BirkanG/EE463-Hardware-Project/README.md

# EE463-Hardware-Project
Wind Turbine Battery Charger AC-DC converter

[Final Report](Final%20Report/EE463%20HardwareProject-FinalReport.pdf)
