BirkanG/EE463-Hardware-Project/mosfet rectifier ltspice/PMOS/link.txt

https://www.digikey.com/en/products/filter/single-fets-mosfets/278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
