BirkanG/EE463-Hardware-Project/buck converter trial/schematic_regulated_v1.png

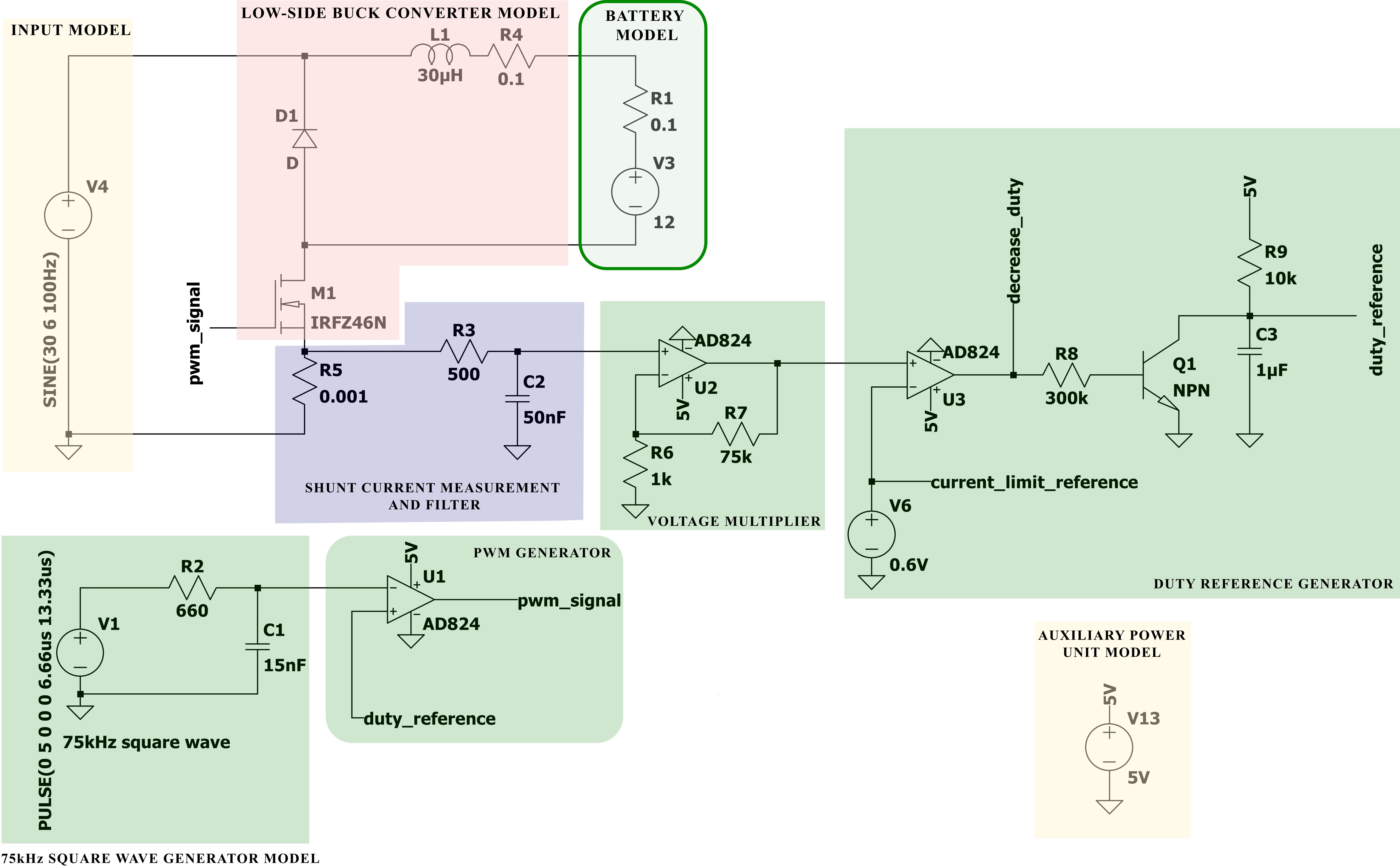
buck converter trial/schematic_regulated_v1.png
