BirkanG/EE463-Hardware-Project/mosfet rectifier ltspice/PMOS/Pmos.PNG

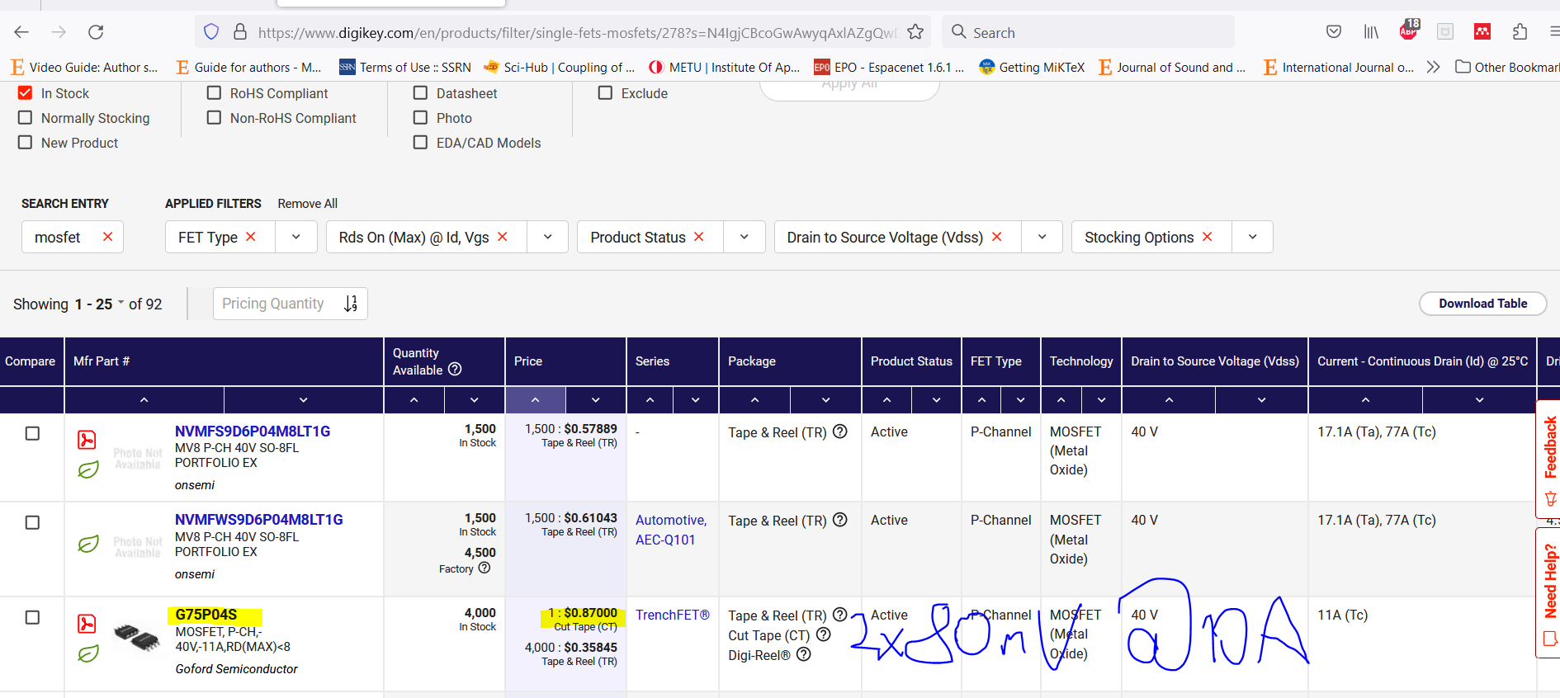
mosfet rectifier ltspice/PMOS/Pmos.PNG
