BirkanG/EE463-Hardware-Project/buck converter trial/results_1.pdf

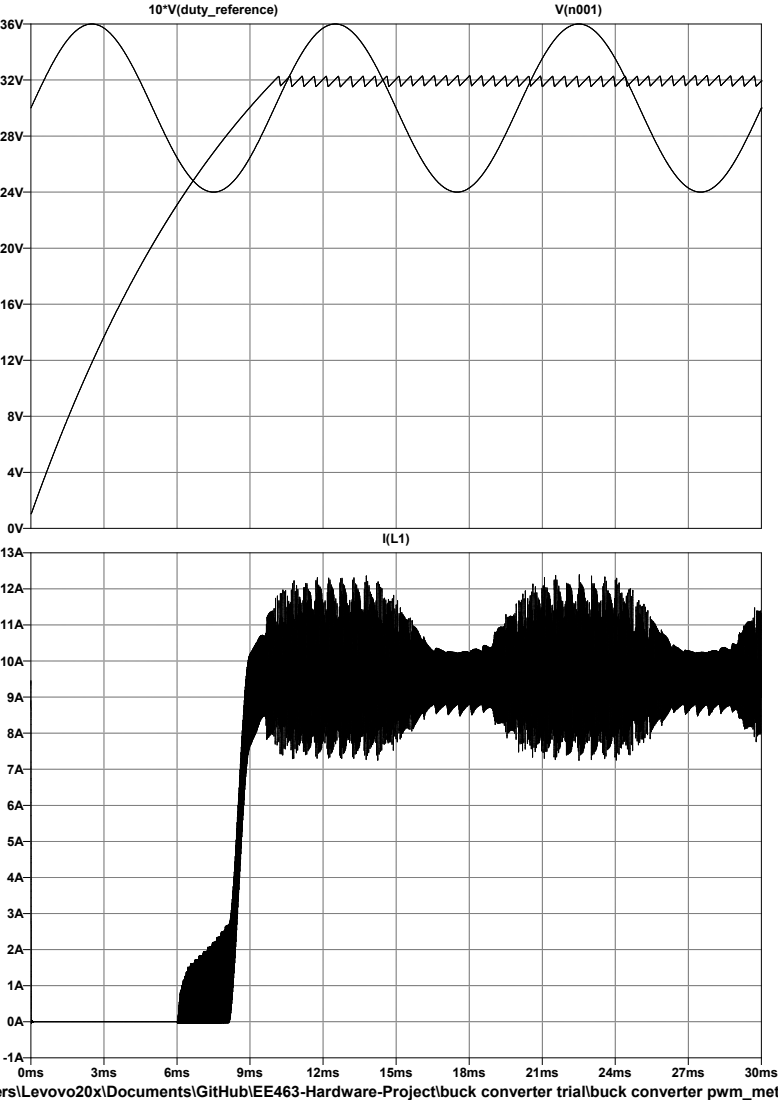
[picture p45: page 1]
10*V(duty_reference)

--- C:\Users\Levovo20x\Documents\GitHub\EE463-Hardware-Project\buck converter trial\buck converter pwm_method.raw ---
