BirkanG/EE463-Hardware-Project/buck converter trial/schematic_regulated_v1.pdf

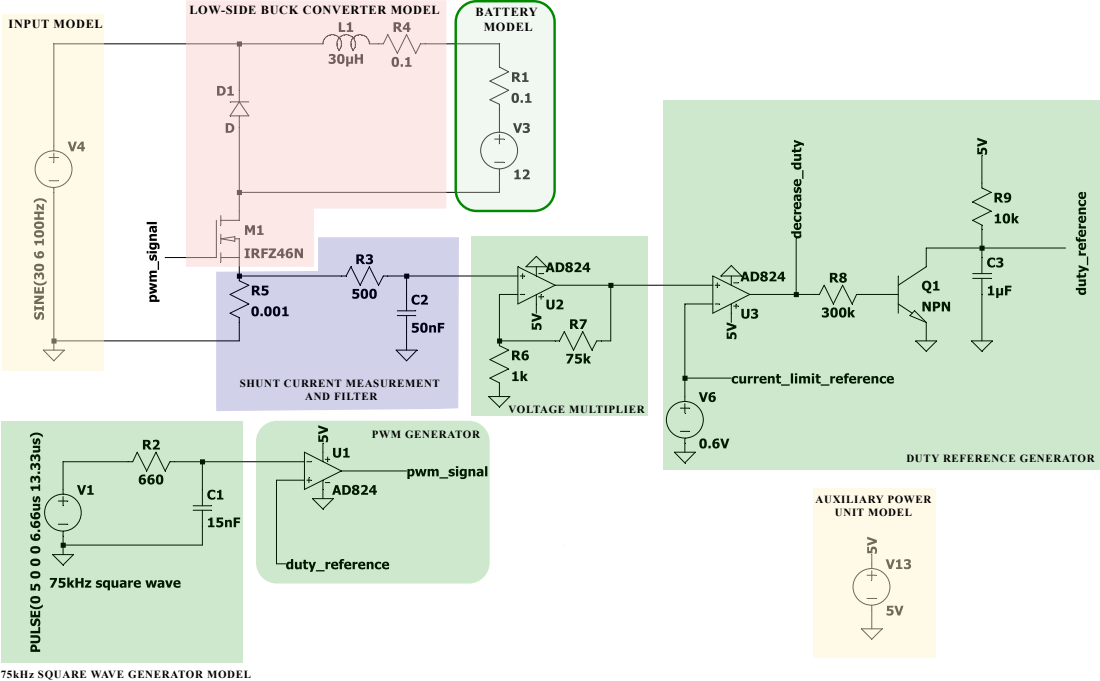
[picture p46: page 1]
INPUT MODEL; BATTERY MODEL; AND FILTER; VOLTAGE MULTIPLIER; AUXILIARY POWER UNIT MODEL; PWM GENERATOR

LOW-SIDE BUCK CONVERTER MODEL

SHUNT CURRENT MEASUREMENT

DUTY REFERENCE GENERATOR

75kHz SQUARE WAVE GENERATOR MODEL
