BirkanG/EE463-Hardware-Project/buck converter trial/second regulated circuit.pdf

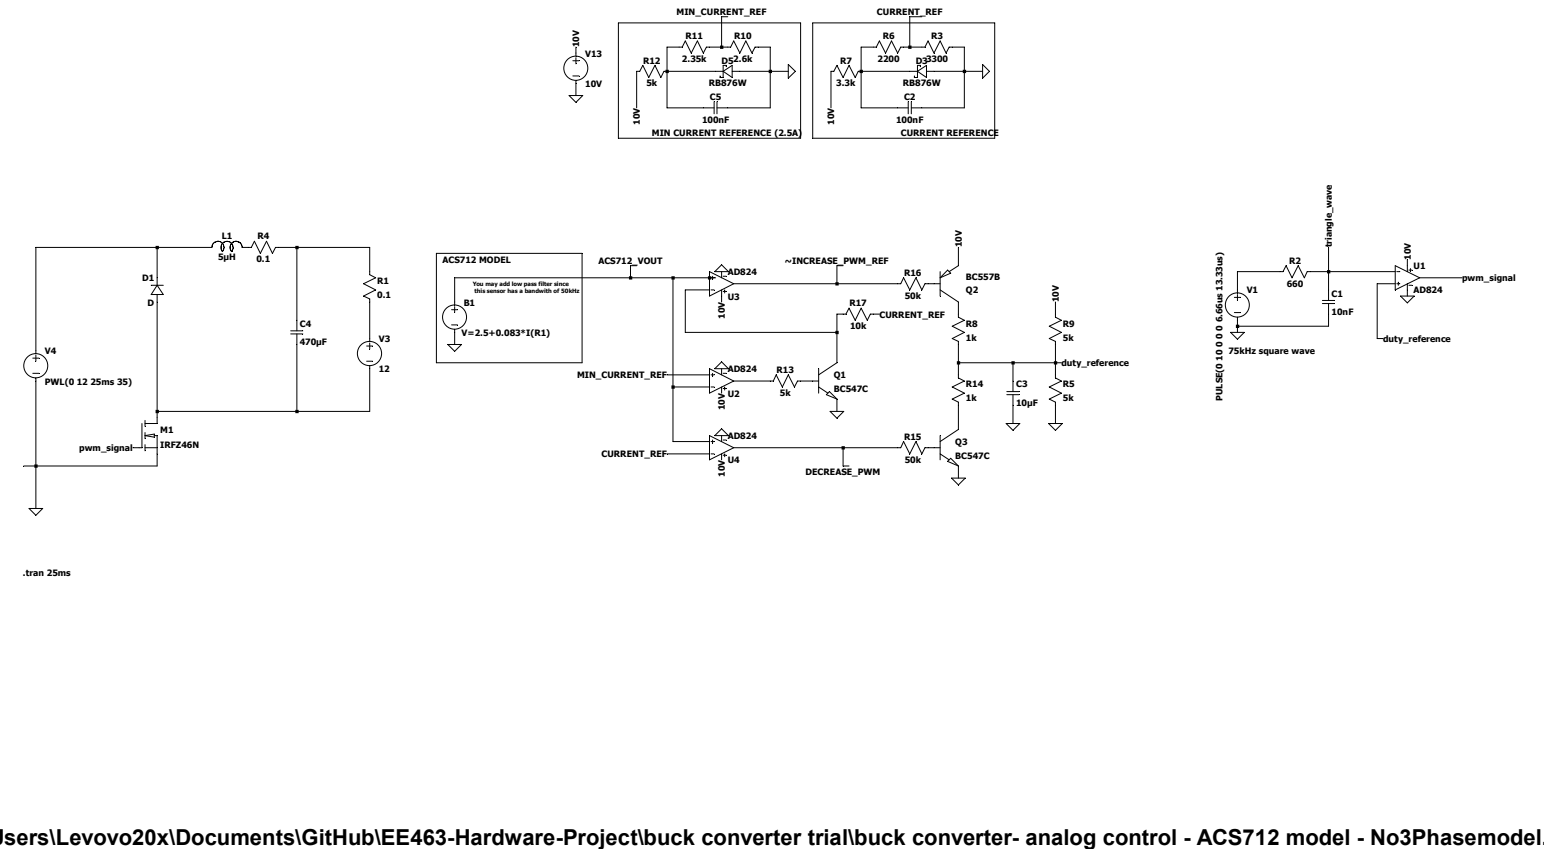
[picture p47: page 1]

You may add low pass filter since
this sensor has a bandwith of 50kHz

--- C:\Users\Levovo20x\Documents\GitHub\EE463-Hardware-Project\buck converter trial\buck converter- analog control - ACS712 model - No3Phasemodel.asc ---
