BirkanG/EE463-Hardware-Project/buck converter trial/first regulated circuit.pdf

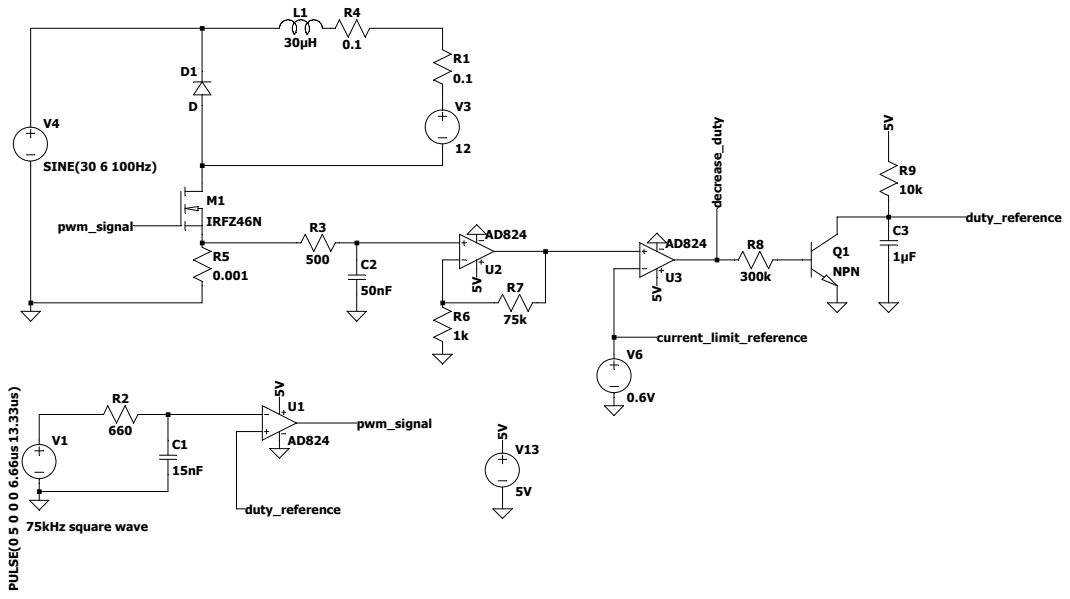
[picture p48: page 1]
