BirkanG/EE463-Hardware-Project/buck converter trial/Draft2.asc

L1: ind
R1: res; 220
U1: SCR; TN6050HP-12
V1: voltage; SINE(0 220V 50)
V2: voltage; PULSE(0 10V 5ms 0 0 1ms 20ms)
Named nets: 0
.tran 20ms
.inc C:\\Program Files\\LTC\\LTspiceXVII\\lib\\st_high-temperature_scr_pspice\\st_high-temperature_scr.lib
