BirkanG/EE463-Hardware-Project/buck converter trial/buck converter- analog control - ACS712 model - No3Phasemodel -Gate driver - PID.asc

B1: bv; V=2.5+0.083*I(R1)
C1: cap; 1nF
C2: cap; 3nF
C3: cap; 100nF
C4: cap; 2200µF
C5: cap; 25nF
C6: cap; 25nF
D1: diode
D2: diode
L1: ind; 10µH
M1: nmos; IRFZ46N
Q1: npn; BC546B
R1: res; 0.05
R2: res; 10k
R3: res; 5k
R4: res; 0.1
R5: res; 10k
R6: res; 5k
R7: res; 5k
R8: res; 1k
R9: res; 1k
R10: res; 4k
R11: res; 1k
R12: res; 200k
R13: res; 10k
R14: res; 10k
R15: res; 25k
R16: res; 10k
R17: res; 10k
R18: res; 10k
R19: res; 10k
R20: res; 10k
R21: res; 10k
R23: res; 1k
R24: res; 5k
R25: res; 10k
R26: res; 10k
U1: AD824
U2: AD824
U3: AD824
U4: AD824
U5: AD824
U6: AD824
U7: AD824
U8: AD824
U9: AD824
V1: voltage; -10V
V2: voltage; 10V
V3: voltage; 12
V4: voltage; SINE(30 8 150)
V5: voltage; 3.33V
V13: voltage; 5V
X1: ir2184
Named nets: 0, 5V, ACS712_VOUT, 10V, TRIANGLE_75kHz, SQUARE_75kHz, PWM_SIGNAL, ERROR_PROPORTIONAL, -10V, ~ERROR_INTEGRAL, ERROR_INTEGRAL, PWM_REFERENCE, ~ERROR_DERIVATIVE, ERROR_DERIVATIVE
ACS712 MODEL
You may add low pass filter since
 this sensor has a bandwith of 50kHz
.tran 0 10ms 0ms
