BirkanG/EE463-Hardware-Project/buck converter trial/buck converter- analog control - ACS712 model - No3Phasemodel -Gate driver.asc

B1: bv; V=2.5+0.083*I(R1)
C1: cap; 1nF
C2: cap; 5nF
C4: cap; 47µF
D1: diode
L1: ind; 15µH
M1: nmos; IRFZ46N
Q1: npn
Q2: pnp
R1: res; 0.05
R2: res; 1
R3: res; 5k
R4: res; 0.1
R5: res; 8k
R6: res; 5k
R7: res; 5k
R8: res; 1k
R9: res; 1k
R10: res; 4k
R11: res; 150k
R12: res; 150k
R13: res; 8k
U1: AD824
U2: AD824
V1: voltage; PULSE(0 10 0 0 0 3us 13.33us)
V2: voltage; 10V
V3: voltage; 12
V4: voltage; 20
V5: voltage; 3.3V
V13: voltage; 5V
Named nets: 0, 5V, ACS712_VOUT, 10V, PROPORTIONAL, TRIANGLE_75kHz, SQUARE_75kHz
ACS712 MODEL
You may add low pass filter since
 this sensor has a bandwith of 50kHz
.tran 5ms
