BirkanG/EE463-Hardware-Project/buck converter trial/buck converter- analog control - ACS712 model - PID.asc

B1: bv; V=2.5+0.083*I(R1)
C1: cap; 2nF
C2: cap; 100nF
C3: cap; 1nF
C4: cap; 100µf
C5: cap; 100nF
C6: cap; 500pF
D1: diode
D3: schottky; RB876W
D5: schottky; RB876W
L1: ind; 10µH
M1: nmos; IRFZ46N
Q1: npn; BC546B
R1: res; 0.1
R2: res; 5k
R3: res; 3.3k
R4: res; 0.1
R5: res; 1k
R6: res; 2.2k
R7: res; 3.3k
R8: res; 4k
R9: res; 5k
R10: res; 2.55k
R11: res; 2.45k
R12: res; 5k
R13: res; 5k
R14: res; 5k
R15: res; 60k
R16: res; 1k
R17: res; 1k
R18: res; 60k
U2: AD824
U3: AD824
V1: voltage; 2.5V
V3: voltage; 12
V4: voltage; 18V
V13: voltage; 10V
Named nets: 0, 10V, pwm_signal, ACS712_VOUT, CURRENT_REF, MIN_CURRENT_REF, SAW_TOOTH
ACS712 MODEL
You may add low pass filter since
 this sensor has a bandwith of 50kHz
.tran 0 5msms 1ms
CURRENT REFERENCE
MIN CURRENT REFERENCE (2.5A)
75KHZ SAWTOOTH GENERATOR
SQUARE WAVE
V2
V1
