BirkanG/EE463-Hardware-Project/buck converter trial/buck converter- analog control - ACS712 model - No3Phasemodel.asc

B1: bv; V=2.5+0.083*I(R1)
C1: cap; 2nF
C2: cap; 100nF
C3: cap; 500nF
C4: cap; 100µf
C5: cap; 100nF
D1: diode
D3: schottky; RB876W
D5: schottky; RB876W
L1: ind; 10µH
M1: nmos; IRFZ46N
Q1: npn; BC547C
Q2: pnp; BC557B
Q3: npn; BC547C
R1: res; 0.1
R2: res; 1.5k
R3: res; 3.3k
R4: res; 0.1
R5: res; 30k
R6: res; 2.2k
R7: res; 3.3k
R8: res; 6.6k
R9: res; 70k
R10: res; 2.55k
R11: res; 2.45k
R12: res; 5k
R13: res; 5k
R14: res; 6.6k
R15: res; 100k
R16: res; 100k
R17: res; 25k
U1: AD824
U2: AD824
U3: AD824
U4: AD824
V1: voltage; PULSE(0 10 0 0 0 6.66us 13.33us)
V3: voltage; 12
V4: voltage; SINE(20 3 150)
V13: voltage; 10V
Named nets: 0, 10V, ~INCREASE_PWM_REF, duty_reference, pwm_signal, triangle_wave, ACS712_VOUT, CURRENT_REF, MIN_CURRENT_REF, DECREASE_PWM
75kHz square wave
ACS712 MODEL
You may add low pass filter since
 this sensor has a bandwith of 50kHz
.tran 0 25ms 1ms
CURRENT REFERENCE
MIN CURRENT REFERENCE (2.5A)
