BirkanG/EE463-Hardware-Project/buck converter trial/behavioral_voltage_source.asc

B1: bv; V=exp(-time/20m)*sin(2*pi*1000*time)
R1: res; 1k
Named nets: 0
.tran 100ms
