BirkanG/EE463-Hardware-Project/buck converter trial/buck converter pwm_method.asc

C1: cap; 25nF
C2: cap; 50nF
C3: cap; 500nF
D1: diode
L1: ind; 60µH
M1: nmos; IRFZ46N
Q1: npn
R1: res; 0.1
R2: res; 660
R3: res; 500
R4: res; 0.1
R5: res; 0.001
R6: res; 1k
R7: res; 75k
R8: res; 10k
R9: res; 5k
R10: res; 5k
U1: AD824
U2: AD824
U3: AD824
V1: voltage; PULSE(0 5 0 0 0 6.66us 13.33us)
V3: voltage; 12
V4: voltage; SINE(27 12 100Hz)
V6: voltage; 0.6V
V13: voltage; 5V
Named nets: 0, 5V, decrease_duty, duty_reference, pwm_signal, current_limit_reference, shunt_voltage, multiplied_shunt_voltage, triangle_wave
75kHz square wave
.tran 0 25ms 0ms
