BirkanG/EE463-Hardware-Project/buck converter trial/buck converter pwm_method_3phase_in.asc

C1: cap; 25nF
C2: cap; 50nF
C3: cap; 500nF
C4: cap; 1000µF
D1: diode
D2: diode
D3: diode
D4: diode
D5: diode
D6: diode
D7: diode
L1: ind; 10µH
M1: nmos; IRFZ46N
Q1: npn
R1: res; 0.1
R2: res; 660
R3: res; 500
R4: res; 0.1
R5: res; 0.001
R6: res; 1k
R7: res; 75k
R8: res; 10k
R9: res; 10k
R10: res; 10k
U1: AD824
U2: AD824
U3: AD824
V1: voltage; PULSE(0 5 0 0 0 6.66us 13.33us)
V2: voltage; SINE(0 11 50 0 0 0)
V3: voltage; 12
V5: voltage; SINE(0 11 50 0 0 120)
V6: voltage; 0.6V
V7: voltage; SINE(0 11 50 0 0 240)
V13: voltage; 5V
Named nets: 0, 5V, decrease_duty, duty_reference, pwm_signal, current_limit_reference, shunt_voltage, multiplied_shunt_voltage, triangle_wave, rectified_p, rectified_n
75kHz square wave
.tran 0 25ms 0ms
