BirkanG/EE463-Hardware-Project/buck converter trial/buck converter- analog control - ACS712 model.asc

B1: bv; V=2.5+0.083*I(R1)
C1: cap; 25nF
C3: cap; 1µF
C4: cap; 1000µF
D1: diode
D2: diode
D3: diode
D4: diode
D5: diode
D6: diode
D7: diode
L1: ind; 10µH
M1: nmos; IRFZ46N
Q1: npn
R1: res; 0.1
R2: res; 660
R3: res; 1k
R4: res; 0.1
R5: res; 1000k
R8: res; 10k
R9: res; 10k
R10: res; 10k
U1: AD824
U3: AD824
V1: voltage; PULSE(0 5 0 0 0 6.66us 13.33us)
V2: voltage; SINE(0 11 50 0 0 0)
V3: voltage; 12
V4: voltage; PWL(0 12 100ms 35)
V5: voltage; SINE(0 11 50 0 0 120)
V6: voltage; 3
V7: voltage; SINE(0 11 50 0 0 240)
V13: voltage; 5V
Named nets: 0, 5V, decrease_duty, duty_reference, pwm_signal, current_limit_reference, triangle_wave, rectified_p, rectified_n, ACS712_VOUT
75kHz square wave
.tran 0 25ms 0ms
Line inductance can be modelled as 0.1mH.
It is ignored to reduce the simulation time.
ACS712 MODEL
You may add low pass filter since
 this sensor has a bandwith of 50kHz
