BirkanG/EE463-Hardware-Project/buck converter trial/buck converter trial.asc

C1: cap; 50nF
C2: cap; 47µF
D1: diode
D2: diode
D3: diode
D4: diode
D5: diode
D6: diode
D7: diode
L1: ind; 30µH
L2: ind; 0.3mH
L3: ind; 0.3mH
L4: ind; 0.3mH
M1: nmos; IRFZ46N
R1: res; 0.1
R2: res; 5
R3: res; 25k
R4: res; 0.1
R5: res; 0.002
R6: res; 500
U1: AD824
U2: AD824
V1: voltage; PULSE(0 15 0 0 0 7us 10us)
V2: voltage; 5V
V3: voltage; 12
V4: voltage; SINE(0 15 50 0 0 240)
V5: voltage; SINE(0 15 50 0 0 120)
V6: voltage; SINE(0 15 50)
V7: voltage; 10mv
V8: voltage; 5V
V9: voltage; 1V
V10: voltage; 24
Named nets: 0, Vsense, increase_pwm_signal_1, increase_pwm_signal_2
.tran 0 15ms 10ms
