BirkanG/EE463-Hardware-Project/buck converter trial/buck converter trial_regulated.asc

C1: cap; 15nF
C2: cap; 100µF
C3: cap; 1µF
D1: diode
D2: diode
D3: diode
D4: diode
D5: diode
D6: diode
D7: diode
L1: ind; 30µH
L2: ind; 0.3mH
L3: ind; 0.3mH
L4: ind; 0.3mH
M1: nmos; IRFZ46N
R1: res; 0.1
R2: res; 660
R3: res; 25k
R4: res; 0.1
R5: res; 0.002
R6: res; 10k
U1: AD824
V1: voltage; PULSE(0 5 0 0 0 6.66u 13.33us)
V2: voltage; PULSE(0 0 0 0 0 2us 10us)
V3: voltage; 12
V4: voltage; SINE(0 15 50 0 0 240)
V5: voltage; SINE(0 15 50 0 0 120)
V6: voltage; SINE(0 15 50)
V7: voltage
V13: voltage; 5V
Named nets: 0, 5V
.tran 0 15ms 10ms
