BirkanG/EE463-Hardware-Project/mosfet rectifier ltspice/Draft1.asc

D1: zener; FTZU6_2E
D2: zener; FTZU6_2E
D3: zener; FTZU6_2E
D4: diode
D5: diode
D6: zener; PTZ10B
D7: diode
D8: zener; PTZ10B
D9: diode
D10: zener; PTZ10B
D11: zener; PTZ10B
D12: diode
D13: diode
D14: zener; PTZ10B
D15: zener; PTZ10B
D16: zener; FTZU6_2E
D17: zener; FTZU6_2E
D18: zener; FTZU6_2E
D19: diode
D20: diode
D21: schottky; RB205T-40NZ
D22: diode
D23: schottky; RB205T-40NZ
D24: schottky; RB205T-40NZ
D25: schottky; RB205T-40NZ
D26: schottky; RB205T-40NZ
D27: schottky; RB205T-40NZ
D28: schottky; RB205T-40NZ
M1: pmos; SP8J5
M2: pmos; SP8J5
M3: pmos; SP8J5
M4: nmos; SP8K5
M5: nmos; SP8K5
M6: nmos; SP8K5
R1: res; 1.3
R2: res; {R0}
R3: res; {R0}
R4: res; 1e5
R5: res; 1e5
R6: res; .001
R7: res; .001
R8: res; {R0}
R9: res; {R0}
R10: res; {R0}
R11: res; {R0}
R12: res; 1.3
R13: res; .001
R15: res; {R1}
R17: res; 1e5
R18: res; .001
R19: res; .001
R20: res; .001
R21: res; {R1}
R22: res; {R1}
R23: res; {R1}
R24: res; {R1}
R25: res; {R1}
R27: res; .001
R28: res; .001
R29: res; .001
R30: res; .001
R31: res; .001
R32: res; .001
V1: voltage; SINE(0 {V} 50)
V2: voltage; SINE(0 {V} 50 0 0 -120)
V3: voltage; SINE(0 {V} 50 0 0 -240)
V4: voltage; SINE(0 {V} 50)
V5: voltage; SINE(0 {V} 50 0 0 -120)
V6: voltage; SINE(0 {V} 50 0 0 -240)
Named nets: 0, ph_gate2, ph_gate3, ph_gate1, o1, p1, p2, p3, o2, p11, p22, p33
.tran 0 .05 0 1e-5
.param R0=1e6 R1=1e4 V=20
.MODEL D1N4001 D IS=29.5E-9 RS=73.5E-3 N=1.96 CJO=34.6P VJ=0.627
+M=0.461 BV=60 IBV=10U
simple rectifier
mosfet rectifier
top loss of mosfet rectifier: (V(o1)-V(p1))*I(R6)+(V(o1)-V(p2))*I(R7)+(V(o1)-V(p3))*I(R13)
top loss of conventional rectifier: (V(o2)-V(p11))*I(R27)+(V(o2)-V(p22))*I(R28)+(V(o2)-V(p33))*I(R29)
