BirkanG/EE463-Hardware-Project/(commit log)

2023-11-26 self switching mosfet rectifier concept
2023-11-26 Buck converter charging circuit is designed
2023-11-28 losses of mosfet rectifier concept and conventional rectifier concepts compared
2023-12-02 rectifier and buck converter simulation
2023-12-27 working PWM
2024-01-23 Simulation files for the circuit.
